Kowd-PauUh/precision-ohmmeter/README.md

# precision-ohmmeter

A dual-mode precision ohmmeter optimized for low-resistance measurement and short circuit localization.

Look into the [datasheet](datasheet/datasheet.pdf) for more information.

## Schematic

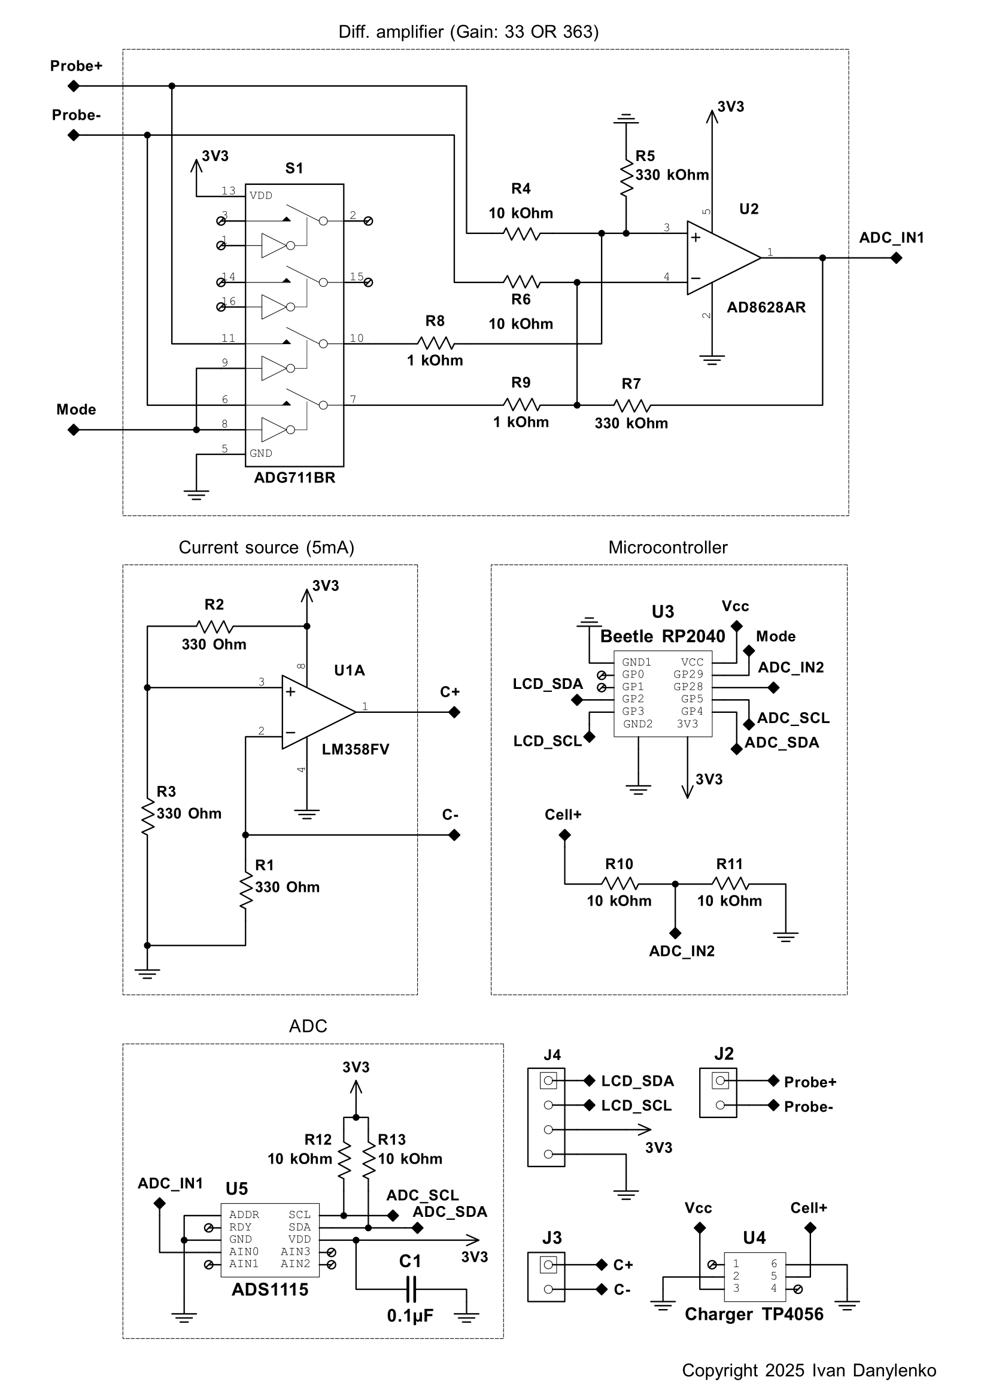
[picture p1: pcb/schematic.png]
Schematic
