Kowd-PauUh/precision-ohmmeter/pcb/layers.pdf

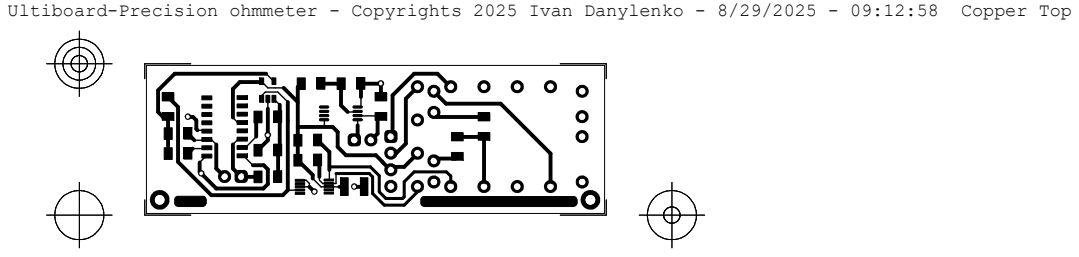
[picture p2: page 1]

Ultiboard-Precision ohmmeter - Copyrights 2025 Ivan Danylenko - 8/29/2025 - 09:12:58 Copper Top

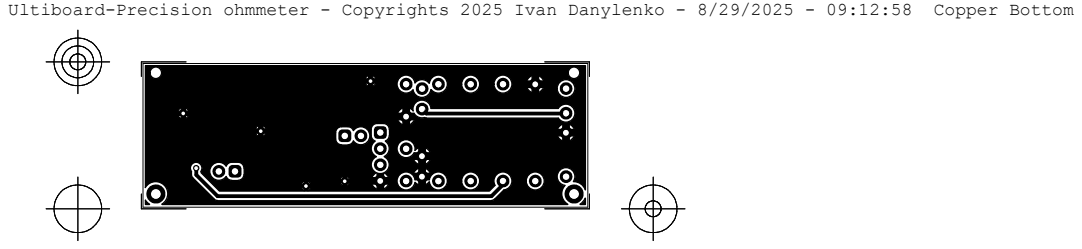
[picture p3: page 2]

Ultiboard-Precision ohmmeter - Copyrights 2025 Ivan Danylenko - 8/29/2025 - 09:12:58 Copper Bottom

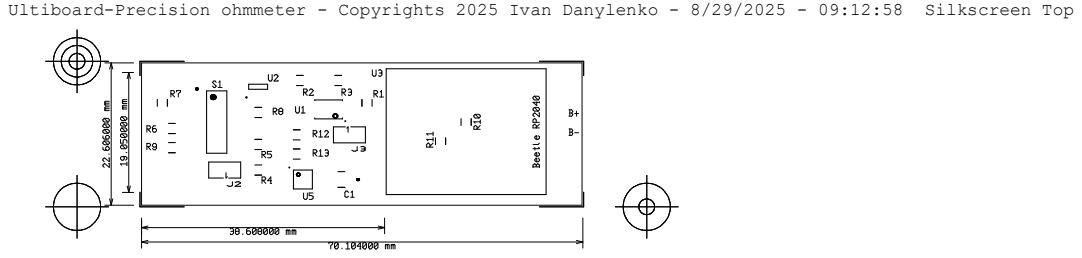
[picture p4: page 3]

Ultiboard-Precision ohmmeter - Copyrights 2025 Ivan Danylenko - 8/29/2025 - 09:12:58 Silkscreen Top

Ultiboard-Precision ohmmeter - Copyrights 2025 Ivan Danylenko - 8/29/2025 - 09:12:58 Silkscreen Bottom

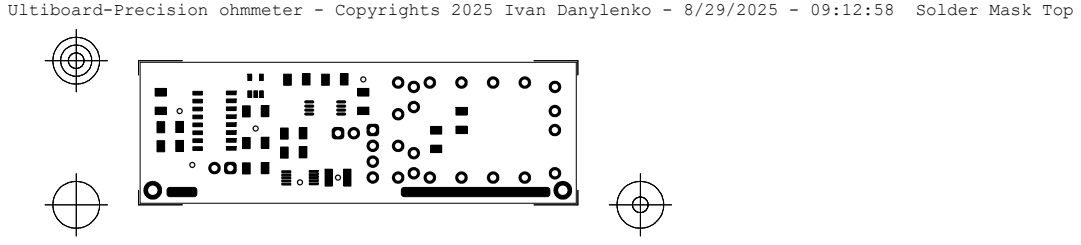
[picture p5: page 5]

Ultiboard-Precision ohmmeter - Copyrights 2025 Ivan Danylenko - 8/29/2025 - 09:12:58 Solder Mask Top

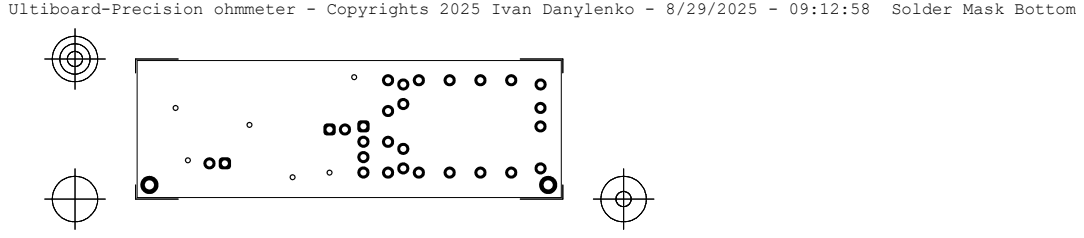
[picture p6: page 6]

Ultiboard-Precision ohmmeter - Copyrights 2025 Ivan Danylenko - 8/29/2025 - 09:12:58 Solder Mask Bottom
