Kowd-PauUh/precision-ohmmeter/pcb/schematic.pdf

4 2 5

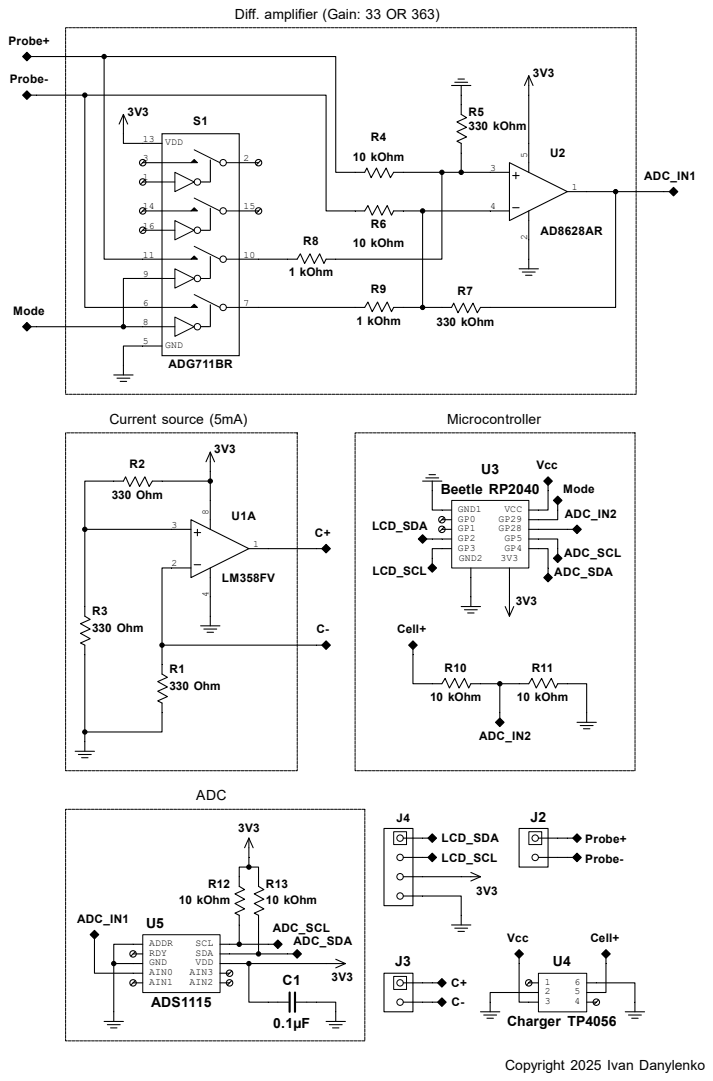
[picture p7: page 1]

Diff. amplifier (Gain: 33 OR 363)
