Kowd-PauUh/precision-ohmmeter/(list of files, drawings)

Other design files:
pcb/ohmmeter.ms14
