Kowd-PauUh/precision-ohmmeter/(commit log)

2025-06-22 Added schematic
2025-06-24 Implemented resistance computation function
2025-06-24 Updated resistance computation with regard to diff. amp. gain
2025-06-24 Added ADC polling
2025-06-24 Added ADC communication lib
2025-06-25 Added voltage measurement display
2025-06-25 Removed gain from resistance computation. Divided voltage instead
2025-06-27 Added mode switch with hysteresis
2025-06-27 Added mode controlling pin setup
2025-06-27 Added microcontroller to schematics
2025-08-19 Added battery charger to schematic
2025-08-19 Added multisim and ultiboard files
    [ohmmeter.ms14]
2025-08-19 Added schematic png
2025-08-19 Added schematic to readme
2025-08-26 Removed debugging pin setup
2025-08-27 Set pin 29 as mode_control_pin
2025-08-27 Added LED blinking on initialization start
2025-08-27 Implemented cell voltage measurement using builtin ADC on pin 28. Implemented buffer averaging mechanism for cell voltage measurement
2025-08-27 Added gerber files in .rar archive
2025-08-28 Updated schematic and PCB layout
    [ohmmeter.ms14]
2025-08-28 Integrated ADC (ADS1115) into schematic
2025-08-28 Refined silkscreen top and bottom
2025-08-29 Added pads for probe soldering
2025-08-29 Added pcb layers print
2025-08-29 Reduced digits after comma for resistance display to 4 (instead of 5)
2025-08-29 Decreased sample rate to 8 SPS
2025-08-29 Added ADC-related subsection to datasheet
2025-08-29 Included analogue switch ON resistance in R8 resistance
2025-08-29 Increased sample rate to 32 SPS
2025-08-31 Increased sample rate to 64 SPS. Enabled voltage readings aggregation. Removed readings averaging for cell voltage. Enforced consistent functions naming.
2025-08-31 Text is displayed in single line, monospace with a unicode symbol. Cell voltage is displayed for 2 seconds after init is begun
2025-08-31 Reduced resistance_str to 10 characters
